ZhangStudyLife/HDUASC-SmartCar-21st-FlyOverMinefield/hardware/docs/LightBoard.md

# 灯板（LightBoard）迭代记录

## 原理图简要说明

这是国赛用的铝基板灯板，分两部分：**TPS54202DDCR 降压电源** + **10 路红外 LED 灯珠负载**。

这个灯板方案比较简单，就是一个降压电路，没有大电流需求

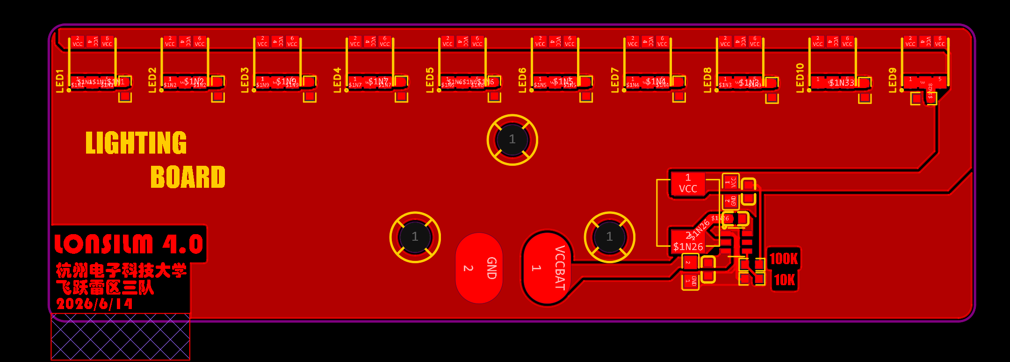
[picture p34: hardware/boards/LightBoard/images/PCB_PCB18_2026-08-30.png]
灯板 PCB


## 总结

整体设计花费的时间不多
