ZhangStudyLife/HDUASC-SmartCar-21st-FlyOverMinefield/structure/national/car/copy20双车f车支架_7.SLDPRT

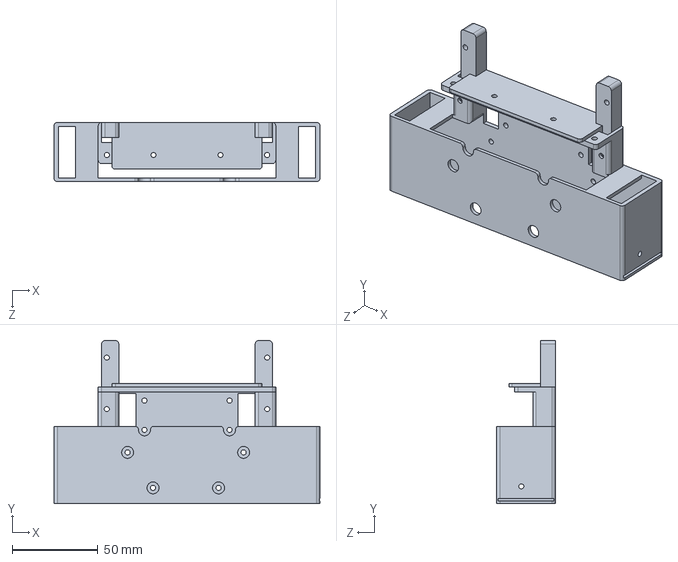
[picture p52: CAD file, 2026-08-27]
structure/national/car/copy20双车f车支架_7.SLDPRT
155.0 x 95.0 x 34.5 mm
