ZhangStudyLife/HDUASC-SmartCar-21st-FlyOverMinefield/structure/provincial/air/无人机v5底板.SLDPRT

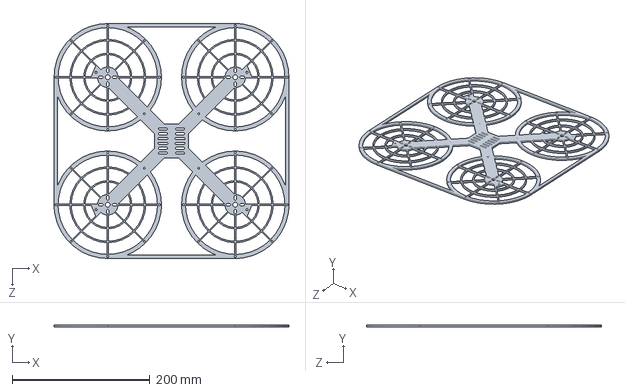
[picture p53: CAD file, 2026-08-31]
structure/provincial/air/无人机v5底板.SLDPRT
341.0 x 3.00 x 341.0 mm
