ZhangStudyLife/HDUASC-SmartCar-21st-FlyOverMinefield/structure/provincial/car/侧板固定轴承固定件_左.SLDPRT

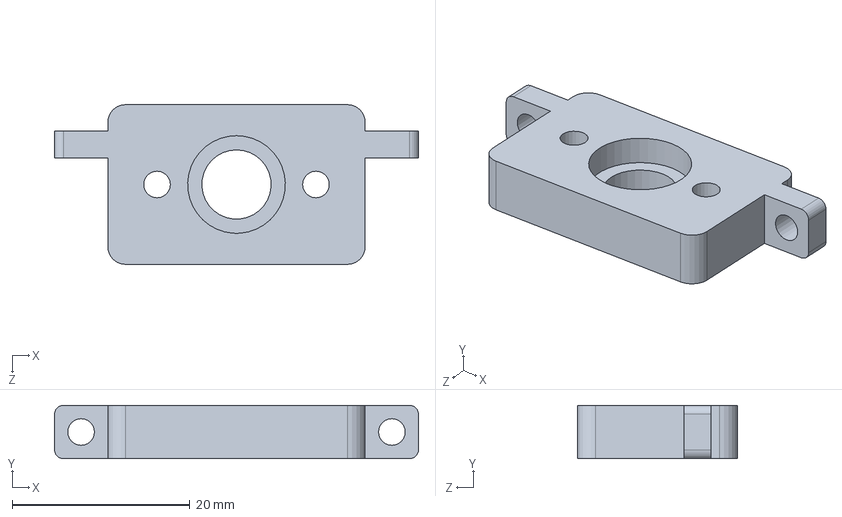
[picture p54: CAD file, 2026-08-27]
structure/provincial/car/侧板固定轴承固定件_左.SLDPRT
41.0 x 6.00 x 18.0 mm
