ZhangStudyLife/HDUASC-SmartCar-21st-FlyOverMinefield/structure/national/car/引线装置v3.1.SLDPRT

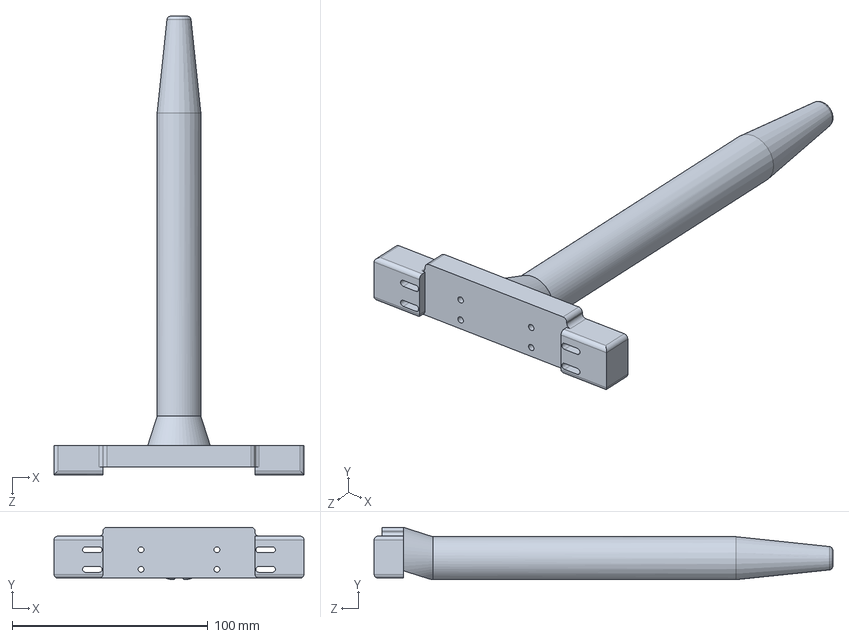
[picture p55: CAD file, 2026-08-27]
structure/national/car/引线装置v3.1.SLDPRT
127.8 x 26.8 x 234.5 mm
