ZhangStudyLife/HDUASC-SmartCar-21st-FlyOverMinefield/structure/provincial/air/无人机v5顶板.SLDPRT

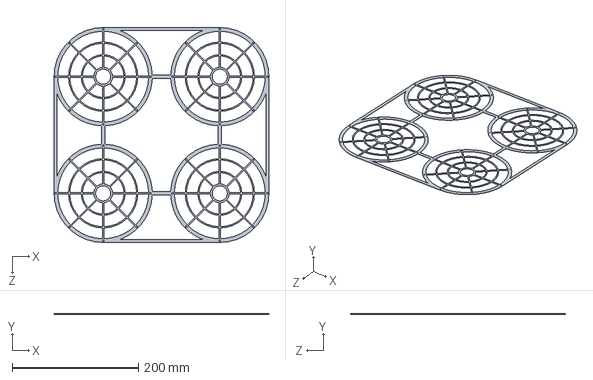
[picture p56: CAD file, 2026-08-31]
structure/provincial/air/无人机v5顶板.SLDPRT
341.0 x 1.00 x 341.0 mm
