ZhangStudyLife/HDUASC-SmartCar-21st-FlyOverMinefield/structure/provincial/car/遮挡_前移v2_后.SLDPRT

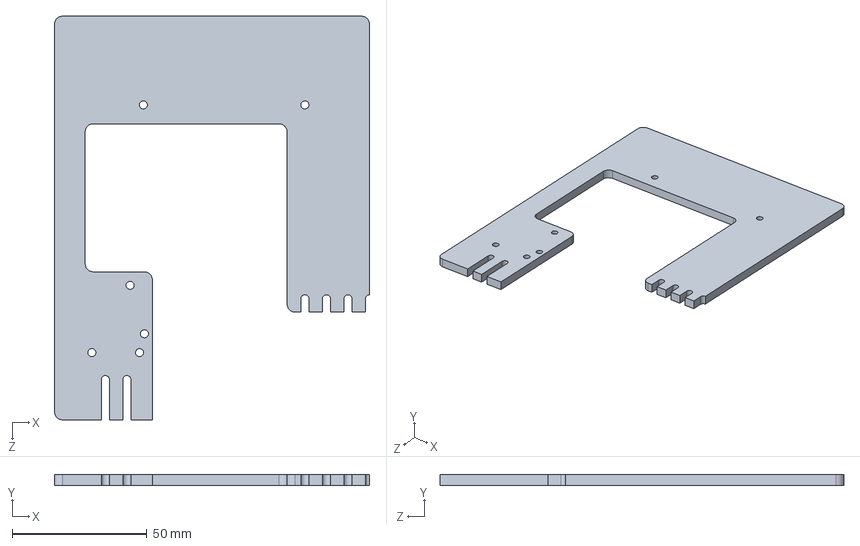
[picture p57: CAD file, 2026-08-27]
structure/provincial/car/遮挡_前移v2_后.SLDPRT
117.0 x 4.00 x 150.0 mm
