ZhangStudyLife/HDUASC-SmartCar-21st-FlyOverMinefield/structure/national/car/桨叶下辐条右后.SLDPRT

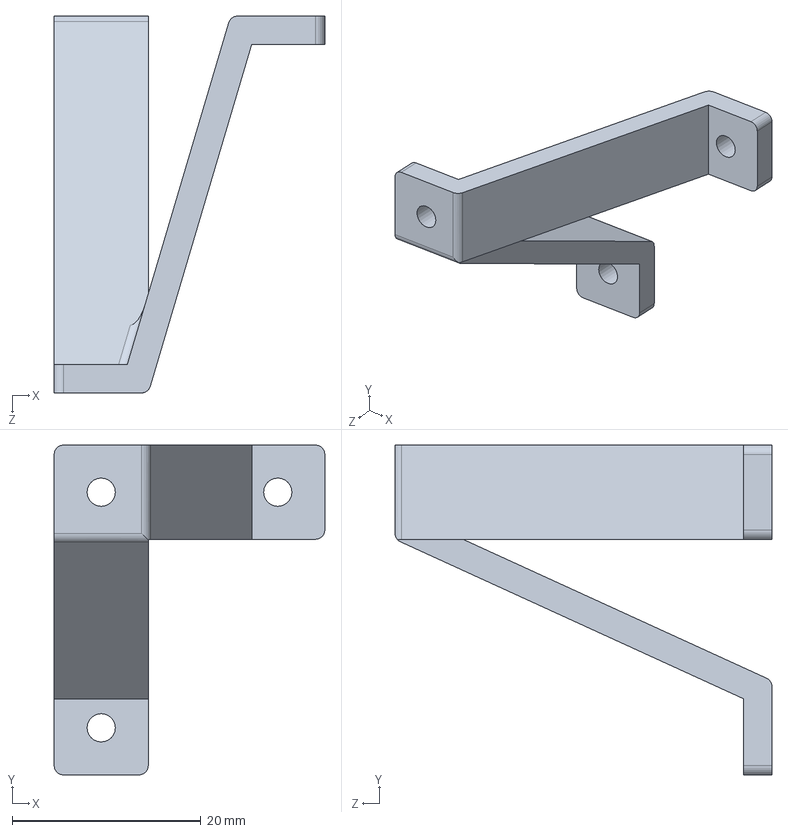
[picture p58: CAD file, 2026-08-27]
structure/national/car/桨叶下辐条右后.SLDPRT
28.7 x 35.0 x 40.0 mm
