ZhangStudyLife/HDUASC-SmartCar-21st-FlyOverMinefield/structure/provincial/car/车模结构_v5.SLDPRT

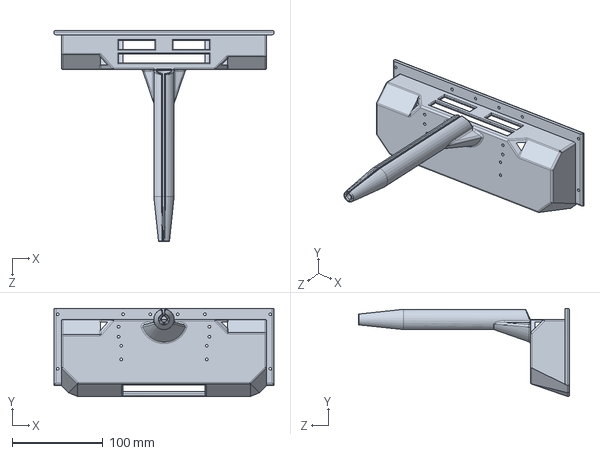
[picture p59: CAD file, 2026-08-27]
structure/provincial/car/车模结构_v5.SLDPRT
242.0 x 96.8 x 232.6 mm
