ZhangStudyLife/HDUASC-SmartCar-21st-FlyOverMinefield/structure/national/car/fCar遮光板_3_前半.SLDPRT

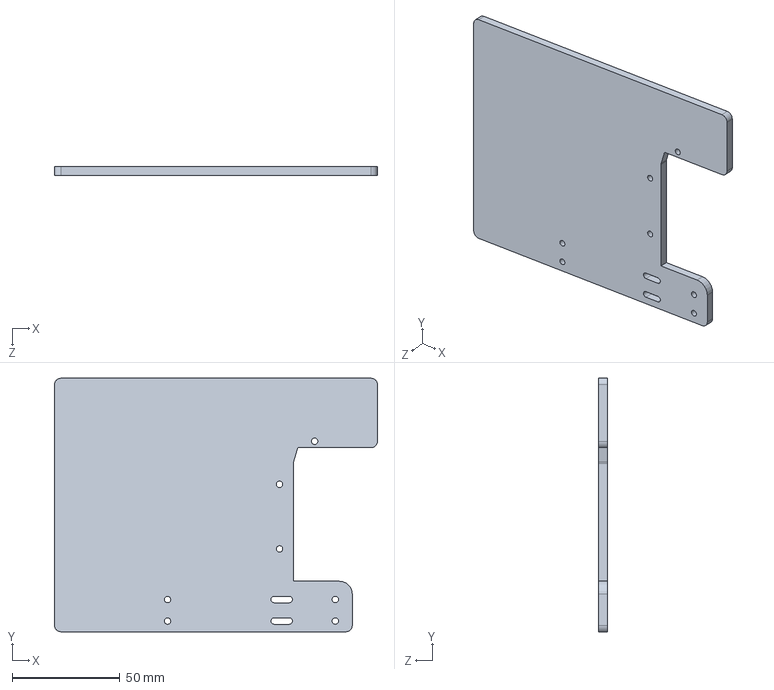
[picture p60: CAD file, 2026-08-27]
structure/national/car/fCar遮光板_3_前半.SLDPRT
150.0 x 117.8 x 4.00 mm
