ZhangStudyLife/HDUASC-SmartCar-21st-FlyOverMinefield/structure/provincial/car/轴侧固定_右侧板有编码器_加高.SLDPRT

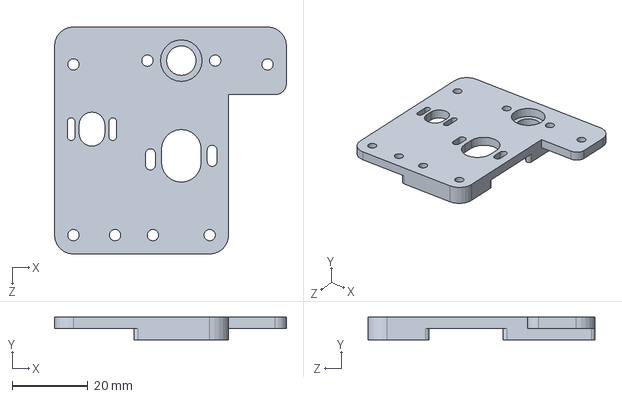
[picture p61: CAD file, 2026-08-27]
structure/provincial/car/轴侧固定_右侧板有编码器_加高.SLDPRT
61.3 x 6.00 x 60.0 mm
