ZhangStudyLife/HDUASC-SmartCar-21st-FlyOverMinefield/structure/provincial/car/车轮罩左.SLDPRT

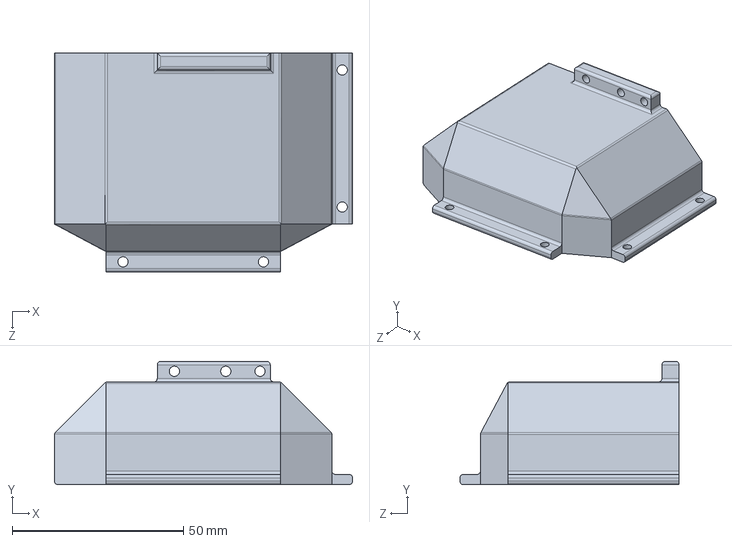
[picture p62: CAD file, 2026-08-27]
structure/provincial/car/车轮罩左.SLDPRT
87.0 x 36.0 x 64.0 mm
