ZhangStudyLife/HDUASC-SmartCar-21st-FlyOverMinefield/structure/national/car/负压_保护v2.SLDPRT

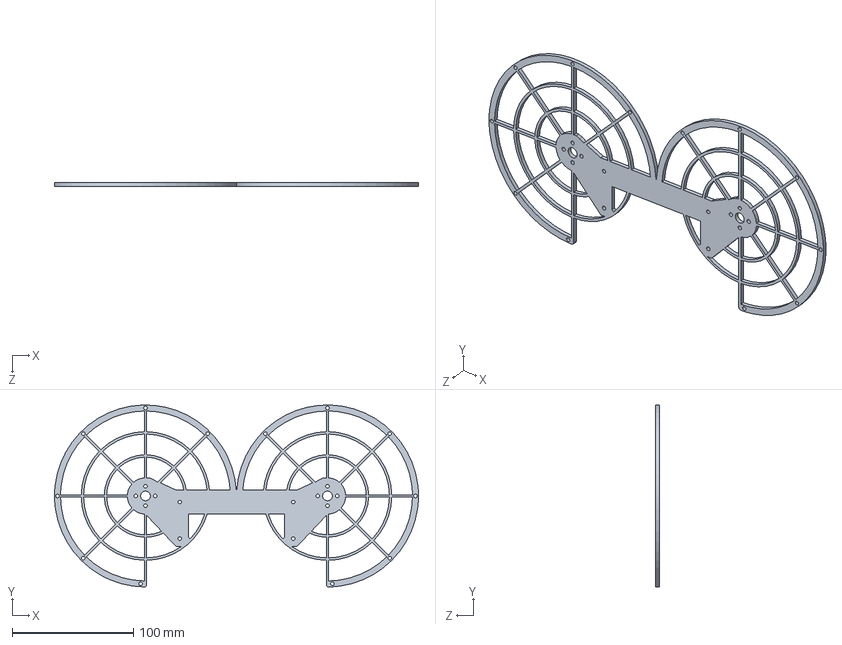
[picture p63: CAD file, 2026-08-27]
structure/national/car/负压_保护v2.SLDPRT
300.0 x 149.9 x 3.00 mm
