ZhangStudyLife/HDUASC-SmartCar-21st-FlyOverMinefield/structure/provincial/car/侧板固定轴中间固定柱.SLDPRT

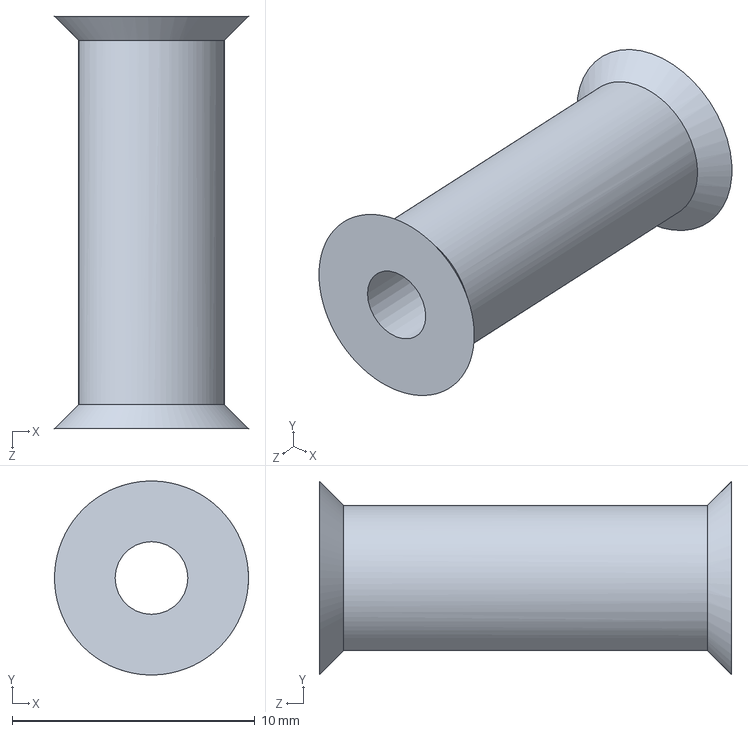
[picture p64: CAD file, 2026-08-27]
structure/provincial/car/侧板固定轴中间固定柱.SLDPRT
8.00 x 8.00 x 17.0 mm
