ZhangStudyLife/HDUASC-SmartCar-21st-FlyOverMinefield/structure/national/car/lightboard_v3.SLDPRT

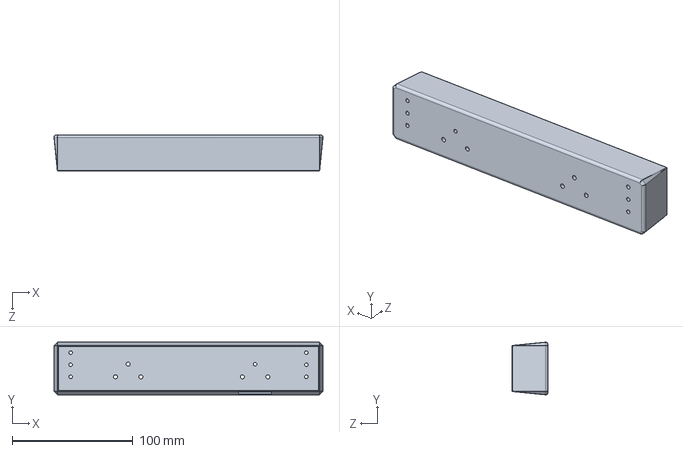
[picture p66: CAD file, 2026-08-27]
structure/national/car/lightboard_v3.SLDPRT
222.6 x 43.6 x 30.0 mm
