ZhangStudyLife/HDUASC-SmartCar-21st-FlyOverMinefield/structure/provincial/car/顶板缩小.SLDPRT

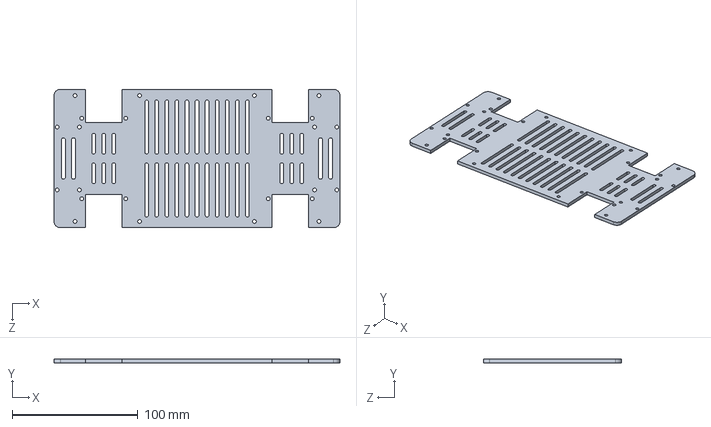
[picture p67: CAD file, 2026-08-27]
structure/provincial/car/顶板缩小.SLDPRT
227.2 x 3.00 x 110.0 mm
