ZhangStudyLife/HDUASC-SmartCar-21st-FlyOverMinefield/structure/national/car/负压_保护v2_上_密.SLDPRT

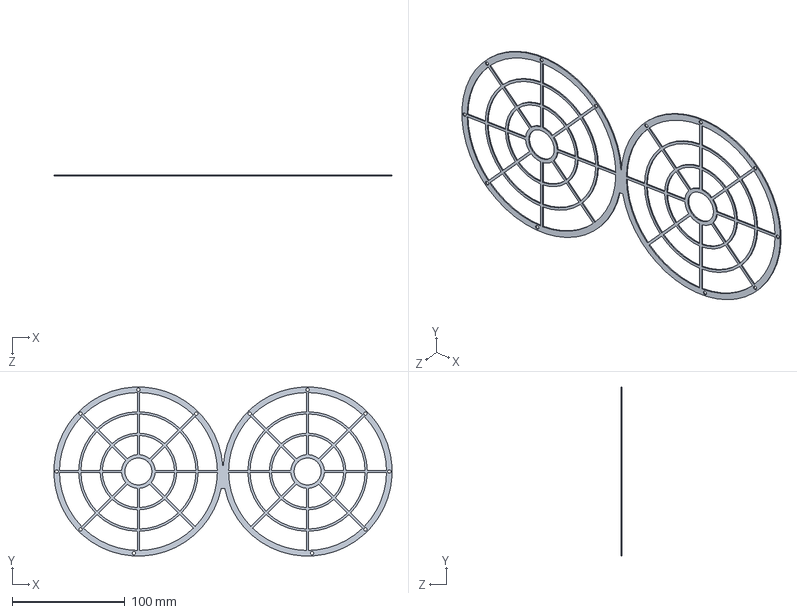
[picture p68: CAD file, 2026-08-27]
structure/national/car/负压_保护v2_上_密.SLDPRT
299.7 x 149.7 x 1.00 mm
