ZhangStudyLife/HDUASC-SmartCar-21st-FlyOverMinefield/structure/provincial/car/左右支撑.SLDPRT

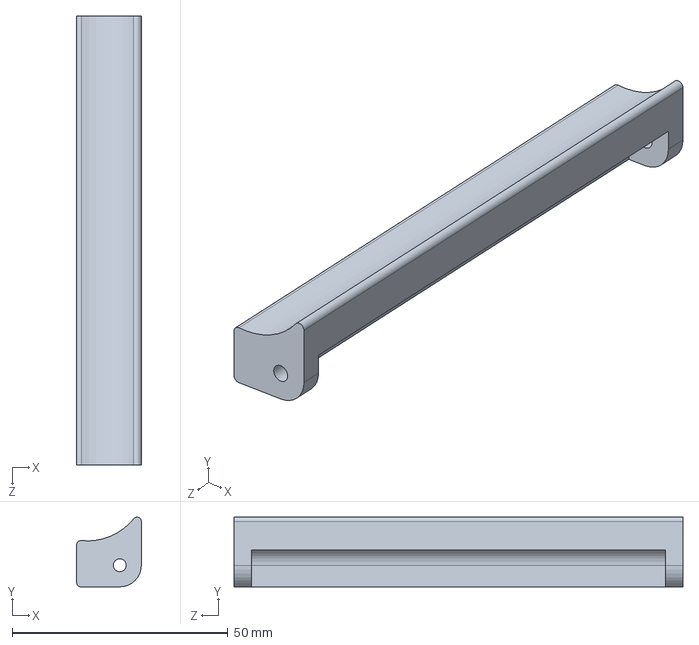
[picture p69: CAD file, 2026-08-27]
structure/provincial/car/左右支撑.SLDPRT
15.0 x 16.2 x 104.0 mm
