ZhangStudyLife/HDUASC-SmartCar-21st-FlyOverMinefield/structure/national/car/万向轮保护.SLDPRT

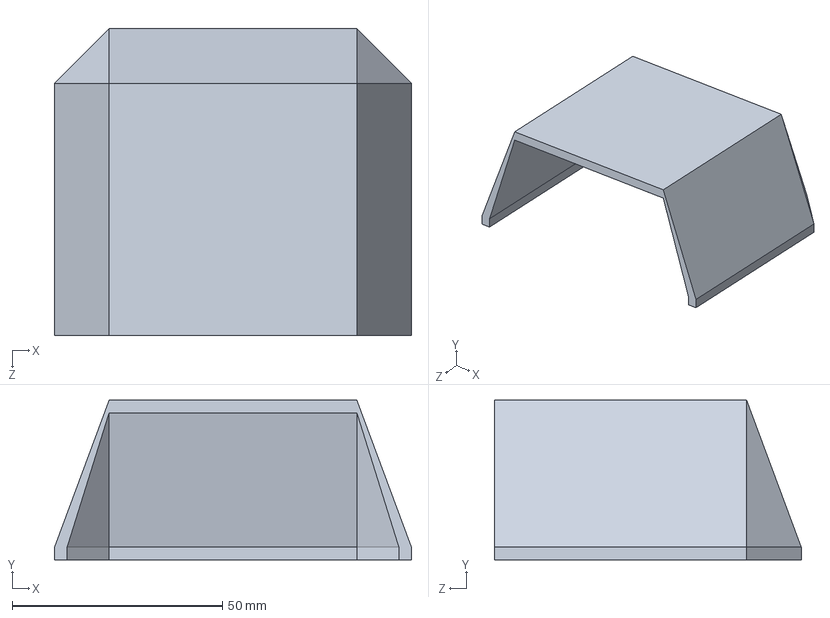
[picture p70: CAD file, 2026-08-27]
structure/national/car/万向轮保护.SLDPRT
85.0 x 38.0 x 73.0 mm
