ZhangStudyLife/HDUASC-SmartCar-21st-FlyOverMinefield/structure/national/car/fCar遮光板_3_后半.SLDPRT

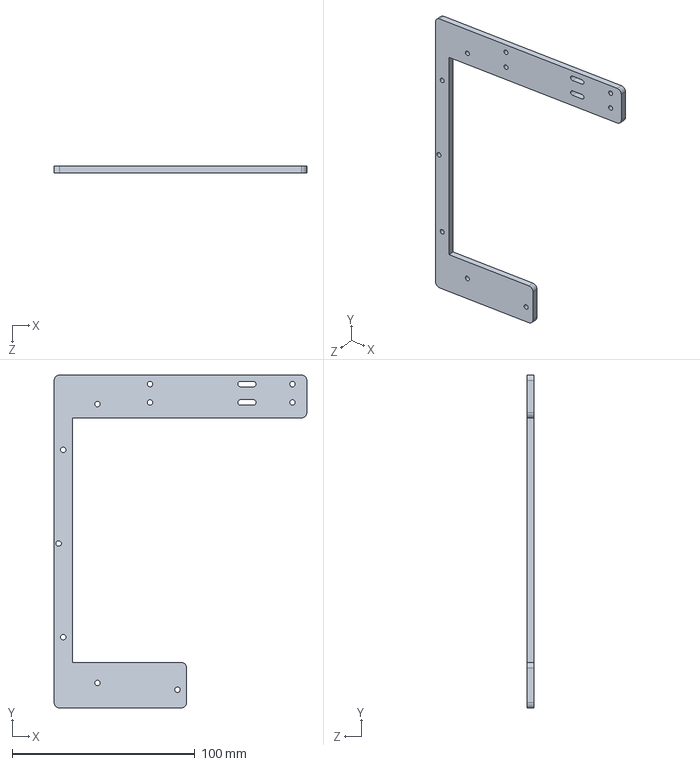
[picture p71: CAD file, 2026-08-27]
structure/national/car/fCar遮光板_3_后半.SLDPRT
138.3 x 182.2 x 4.00 mm
