ZhangStudyLife/HDUASC-SmartCar-21st-FlyOverMinefield/structure/provincial/car/lightboard_v2.SLDPRT

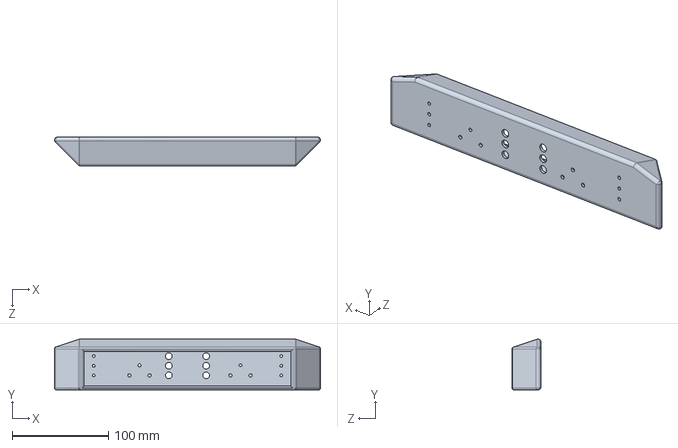
[picture p72: CAD file, 2026-08-27]
structure/provincial/car/lightboard_v2.SLDPRT
276.5 x 52.8 x 30.0 mm
