ZhangStudyLife/HDUASC-SmartCar-21st-FlyOverMinefield/structure/national/car/负压_保护v2_上_空.SLDPRT

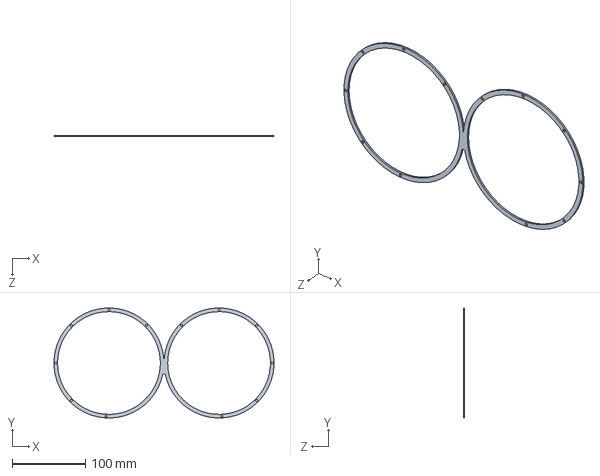
[picture p73: CAD file, 2026-08-27]
structure/national/car/负压_保护v2_上_空.SLDPRT
299.7 x 149.7 x 2.00 mm
