ZhangStudyLife/HDUASC-SmartCar-21st-FlyOverMinefield/(list of files, cad)

Other CAD files:
structure/national/air/国赛飞机顶板.DWG
structure/national/air/国赛飞机底板.DWG
structure/national/car/桨叶下辐条左前.SLDPRT
structure/provincial/car/轴侧固定_左侧板有编码器_加高.SLDPRT
structure/national/car/桨叶下辐条左后.SLDPRT
structure/national/car/桨叶下辐条右前.SLDPRT
structure/provincial/car/车轮罩.SLDPRT
