ZhangStudyLife/HDUASC-SmartCar-21st-FlyOverMinefield/(commit log)

2026-05-12 初始化的提交,在这个提交里面,msj晚上测试了部分的空地串口的通信
2026-05-12 当前空地通信测试了以下部分: 改参数 , flash , 心跳 遥感数据发送和解析还没有进行测试
2026-05-13 feat: 实现空地双向实时数据通信并新增通信手册 - CYT4bb7_Car: 车端100Hz发送编码器+IMU数据，接收飞机TOF+IMU回传 - CYT4BB7_Air: 飞机端100Hz发送TOF+IMU数据，接收车端编码器+IMU回传 - 新增空地通信互传数据手册.md，记录数据协议和收发代码模板 - 已测试双向数据收发正常，EXEC_FUNC远程调用尚未测试
2026-05-13 feat: 纳管CYT2BL3图像处理子项目并补充总仓说明
2026-05-14 测试过当前节点,车主控和从机的通信没有问题
2026-05-14 更新使用手册 , 以后空地通信就看这个 车主控100HZ轮询3块小板
2026-05-14 更新CYT4BB7_Air子仓库：合并空地串口功能
    合并 origin/空地串口函数功能 到 bare-chip-onlyM0
    - 重构 air_comm_air 通信模块 (+467/-118)
    - 新增 air_remote_cmd 远程命令功能
2026-05-18 车不再使用sbus遥控器 , 改为串口接收飞机命令,图像初步融合
2026-05-21 更新CYT4bb7_Car子仓库节点
2026-05-24 更新CYT2BL3_Image和CYT4bb7_Car子仓库的提交记录
2026-05-26 小板的单信标位置发给车控,同时更新空地串口发送的内容
2026-05-26 飞机更新跟车,但是感觉瓶颈在飞机的速度环了
2026-06-04 此节点可以勉强跟车,但是感觉速度环还是哪里有毛病
2026-06-05 飞机机械中值调整
2026-06-09 更新图像 SPI 通信 goal 子仓库指针
    记录 Air、2BL3 Image、Car 三个子仓库的本次 goal 完成结果：飞机核心1承担图像 SPI 主机，两块 2BL3 图像小板适配 SPI 从机通信，车端清理图像小板通信残留。
    新的 SPI 主从通信仅完成离线静态审查和工程配置检查，尚未进行硬件实际测试。
2026-06-10 更新文档
2026-06-12 图像更新
2026-06-12 主从通信测试成功,但是还存在以下问题"CS 拉太久 + slave 在被读时改 FIFO。改完这两点，FF FF 应该消失大半"
2026-06-12 修复SPI通信：CS及时释放+从机SS低时不重装FIFO
2026-06-12 SPI主从库内聚重构，接口收敛Init+Update，双板100Hz
2026-06-12 更新飞控与图像子仓库：SPI内聚重构、图像算法解耦统一
2026-06-13 在这个分支,实现了核心0和核心1都可以正确拿到图像板的数据,并接入了完全体的飞控
2026-06-15 发送空地串口debug信息
2026-06-16 改车wifispi引脚吗，车飞ip改为李文轩，串口通信可以跑通
2026-06-16 wifispi的ip均改为张跃哲 , 此节点表示这个是2代飞机的节点
2026-06-16 车机能完赛，但是车控制有问题
2026-06-19 遥控器在mode8,飞机自动跟灯光的yaw闭环,车跟飞机的yaw!
2026-06-19 增加飞机和车模的mode5,对齐mode8,还是飞机跟车,车遥控,为后续的车自动埋下预留
2026-06-19 张跃哲牛逼!张跃哲第一次完赛!!!26S10个灯,牛逼张跃哲!!!存在问题就是车的yaw,会多绕一圈
2026-06-20 车yaw闭环更硬了,不会出现莫名其妙的自旋一圈问题,但是当前问题就是车的轨迹,和选择目标很陡,一直在切换,中间过渡不流畅
2026-07-05 fc_parans里面变量g_2bl3_image_send_enable决定2bl3是否发送图像 , 新飞机开始调节
2026-07-05 新飞机可以完赛的版本 , 电调会有点小问题
2026-07-05 当下摄和前摄只看到车灯没有信标灯,后摄只看到信标灯没有看到车灯情况下,车根据飞机的yaw闭环,然后直接向后走,直到后摄同时看到车灯和信标灯. 效果还可以,没有出现明显卡顿.总共灭40个灯,平均1个灯3.3s
2026-07-06 40个灯,差不多130s左右,问题是飞机跟不上车 以及飞机刹车不下来
2026-07-07 缪沈杰的图像的检测灭信标,进行惯导的矫正,car_plan和target_yaw算法的优化,但是车速度快了就会拉扯飞机
2026-07-12 本次是张跃哲mode8跟车相比较很牢的效果
2026-07-12 当前可以做到随机10个灯 , 差不多都是25s 问题在于1.车跑过灯然后再回头灭灯 2.速度快,飞机抖的厉害
2026-07-14 速度没变化 , mode2还需要仔细调 , 加入了菜单以及2bl3的调参
2026-07-14 车可以修改飞机端的mode2的参数 , 车速度的前馈应该yaw的旋转映射
2026-07-14 菜单可以修改car_plan里面车的追灯速度
2026-07-15 图像从最新节点拿过来的 , mode2增加了加速度前馈,车速前馈从车体坐标系转换到机体坐标系,car_plan小变化 , mode8的遥控器改为水平坐标系遥控,mode8的yaw不再跟随信标灯,而是测试数据yaw
2026-07-15 16凌晨_zyz开始调试
2026-07-15 新增看不见车灯的速度 进入菜单
2026-07-15 更新飞机蜂鸣器报警管理
2026-07-17 mode3使用图像域 , 控制器使用p^2 , 换了光流的速度估计 , 把光流当作测量飞机和车模的相对位移的传感器 , 当前节点默认参数 车模1.2m跑起来比较稳定的
2026-07-19 chore: 更新菜单合并子仓库版本
2026-07-19 chore: 更新Car子仓库存档修复版本
2026-07-19 修复了菜单和核1卡死的问题 , 新增可调目标高度
2026-07-19 此节点最高可以达到17s12灯的速度 , 但是得看车模是否正上信标
2026-07-19 提交参数限幅
2026-07-24 省赛节点 , 此节点的代码完成了省赛第一的壮举.
2026-07-24 chore: 统一省赛完赛分支跟踪
2026-07-24 更新空地日志清理节点
2026-07-24 切换至国赛开发分支
2026-07-24 添加差速车子仓库
2026-07-24 添加浅克隆指令
2026-07-24 恢复 README 标题
2026-07-24 完善克隆与子仓库说明
2026-07-26 docs: design car gyro-z loop migration
2026-08-08 此节点为f车和小飞机来联调的第一个合并节点,mode2小飞机跟随没有仔细调 然后车模速度上传还没有做 , 车模速度标定也没写
2026-08-10 这个mode2感觉手感不错!
2026-08-11 mode1联动 , 但是车感觉就是那种扭扭车一样的
2026-08-11 还是扭扭车 , 提交日志看能不能从像素域->真实角度
2026-08-11 这个第一版本改car_plan2,加了镜头畸变修复,稍微有人样子
2026-08-11 可以稳定完赛版本 , 但是图像还没有更新到100hz , 然后就是车模有的时候会莫名其妙转动90°
2026-08-11 图像控制环改为100HZ,但是实际上控制还没有接入100HZ,仍然按照50HZ进行控制,下次改为100HZ的
2026-08-12 docs: design camera mapping visualizer
2026-08-12 docs: refine camera visualizer orientation
2026-08-13 20个灯 40S , 中间会有很多莫名其妙的旋转导致有问题 , 车的路径和图像有问题
2026-08-13 整理通信文档与子仓库
2026-08-14 36s 20灯 偏稳定
2026-08-14 同步飞机与F车多模式独立控制版本
    飞机端更新至fc521f5，完成Mode1/4/5独立控制与参数同步。
    F车端更新至738e889，完成多模式独立控制、零PWM模式及179项参数菜单。
2026-08-15 mode4/5 主要修改车端的转向逻辑 最快32s 20个灯
2026-08-15 车端mode3改为空 对应飞机的mode3改为纯手动
2026-08-15 更新空车多模式调试日志
2026-08-15 更新车端WiFi日志修复
2026-08-17 docs: design equivalent positional speed pid
2026-08-18 速度规划,可以提提速度
2026-08-19 新增yawmode2.看不到信标灯500ms会自己旋转
2026-08-19 增加mode4的飞机的自动降落
2026-08-19 docs: define cable-aware yaw search
2026-08-19 更新飞机子仓库：合入队友图像菜单与下摄算法
2026-08-19 docs: design fast hover throttle I transfer
2026-08-19 docs: revise yaw search validity design
2026-08-20 28s/10个 没招了 plan3和plan4感觉差不多 还是图像瓶颈
2026-08-25 chore: 纳管并锁定国赛上位机版本
2026-08-25 chore: 更新 Air 和 Car_F 子模块版本
2026-08-25 更新air端的imu/height 文档,删除老旧的杂糅的文档
2026-08-27 删除codex生成的大部分plan文档,更新air菜单里面的 真实有用的经验分享文档
2026-08-27 建立好空的结构说明文档了
2026-08-27 清理无用文档
2026-08-27 提交省赛车模和国赛车模的结构件
    [copy20双车f车支架_7.SLDPRT, fCar遮光板_3_前半.SLDPRT, fCar遮光板_3_后半.SLDPRT, lightboard_v2.SLDPRT, lightboard_v3.SLDPRT, 万向轮保护.SLDPRT, 侧板固定轴中间固定柱.SLDPRT, 侧板固定轴承固定件_左.SLDPRT]
2026-08-28 国赛结构readme提交
2026-08-29 add hardware: 7 块自研板卡（飞控/车控/图像/电调/有刷/灯板/陀螺仪）
2026-08-29 restructure hardware: per-board docs + boards directory
2026-08-29 去掉无用文档
2026-08-29 更新AI写的多摄像头标定的算法说明
2026-08-29 更新PCB文件 , 并且修复跳转错误的路径问题
2026-08-29 简洁修改飞控板的迭代文档
2026-08-29 使得总仓库的文档跳转更加合理
2026-08-29 更新图像板子模块指针
2026-08-30 更新回忆录
2026-08-30 更新图片命名
2026-08-30 更新 飞书文档链接
2026-08-30 修改错别字
2026-08-31 总文档写的链接跳转什么的进行了补充
2026-08-31 省赛飞机结构进行补充
    [无人机v5底板.SLDPRT, 无人机v5顶板.SLDPRT]
2026-08-31 docs: 统一排版并补齐各板迭代记录；boards: 新增板卡图片与源文件
2026-08-31 docs: 完善电调/灯板等迭代文档并统一格式；boards: 国赛版源文件统一命名
2026-09-01 统一项目文档与仓库发布格式
2026-09-01 更新子仓库格式整理版本
2026-09-01 更新国赛飞机结构件
    [国赛飞机底板.DWG, 国赛飞机顶板.DWG]
2026-09-01 docs: add direct PCB source downloads
2026-09-02 修复路径问题
2026-09-03 提问补充
2026-09-16 docs: 补充浙江省赛区一等奖证书并规范配图命名
    - 新增 image/README/浙江省赛区飞跃雷区一等奖证书.png，替换编辑器粘贴时生成的
    时间戳文件名 1789564163600.png，与 image/忆往昔/ 的中文描述式命名保持一致
    - 获奖证书章节：标题行还原为纯标题，配图独立成居中的 <p align="center"> 块，
    宽度 70%，补全 alt 文案
