ZhangStudyLife/HDUASC-SmartCar-21st-FlyOverMinefield/image/忆往昔/1788073048283.jpg

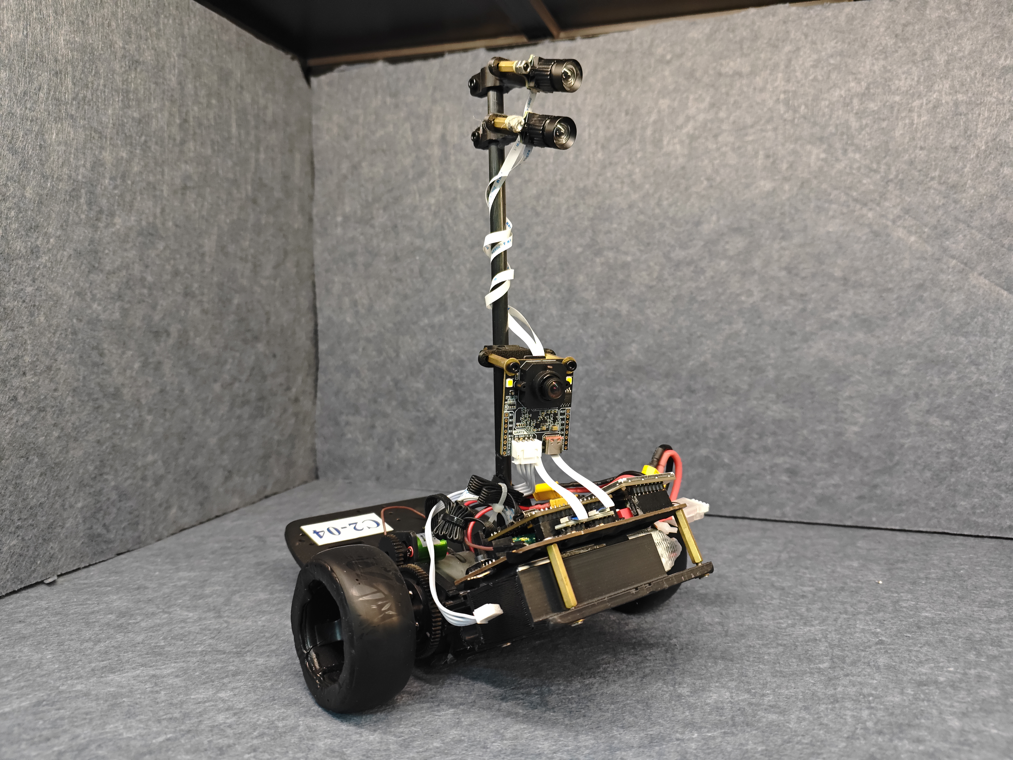
[picture p46: image/忆往昔/nxp-平衡竞速车模-双CCD成品照.jpg]
image/忆往昔/1788073048283.jpg
